ItzBuble/Bubleboard/3D Models/Keyboard_Armrest_Left.3mf

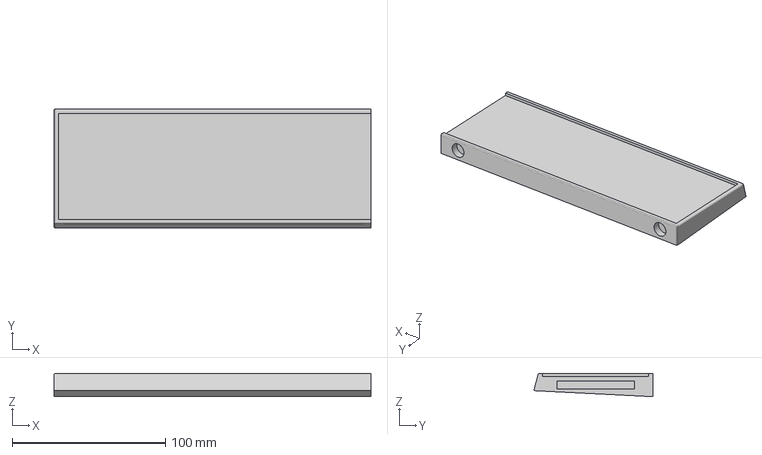
[picture p2: CAD file, 2026-10-11]
3D Models/Keyboard_Armrest_Left.3mf
207.0 x 78.0 x 15.3 mm
