ItzBuble/Bubleboard/3D Models/Keycaps/1.25x1.3mf

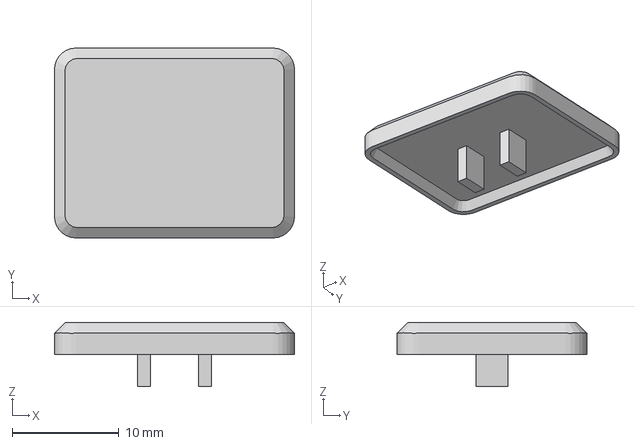
[picture p3: CAD file, 2026-10-11]
3D Models/Keycaps/1.25x1.3mf
22.5 x 17.8 x 6.02 mm
