ItzBuble/Bubleboard/3D Models/Keyboard_Case_Left.3mf

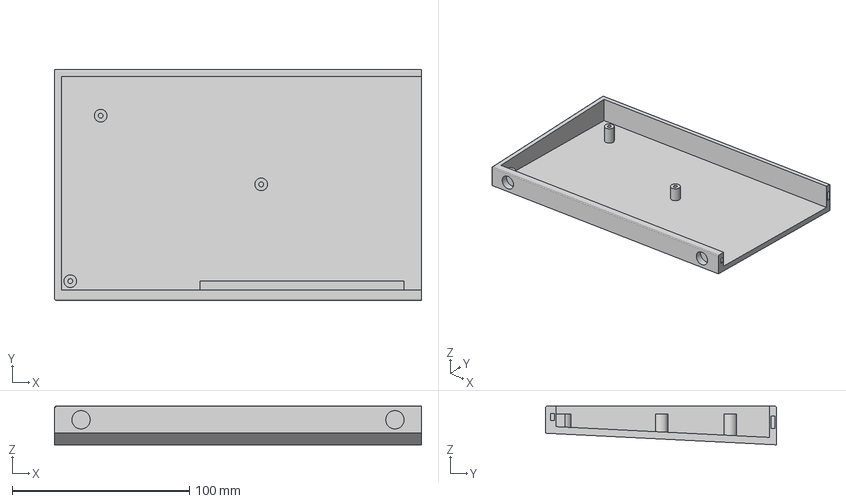
[picture p4: CAD file, 2026-10-11]
3D Models/Keyboard_Case_Left.3mf
207.0 x 130.3 x 21.8 mm
