ItzBuble/Bubleboard/3D Models/Keycaps/1x1.3mf

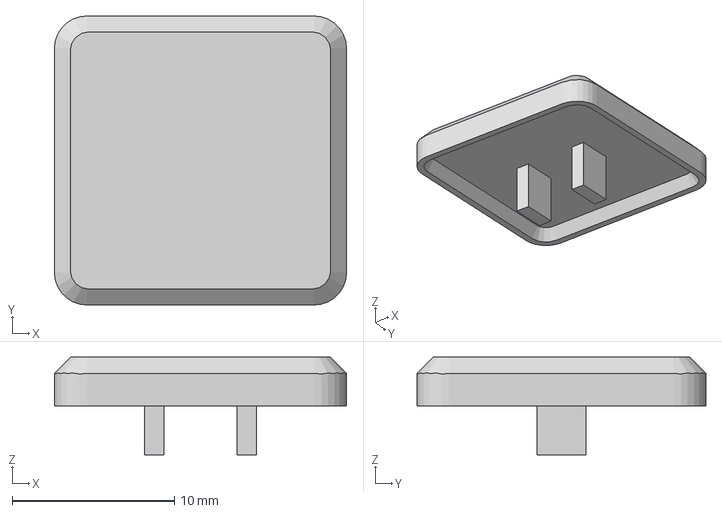
[picture p5: CAD file, 2026-10-11]
3D Models/Keycaps/1x1.3mf
18.0 x 17.8 x 6.02 mm
