ItzBuble/Bubleboard/3D Models/Keycaps/2.25x1.3mf

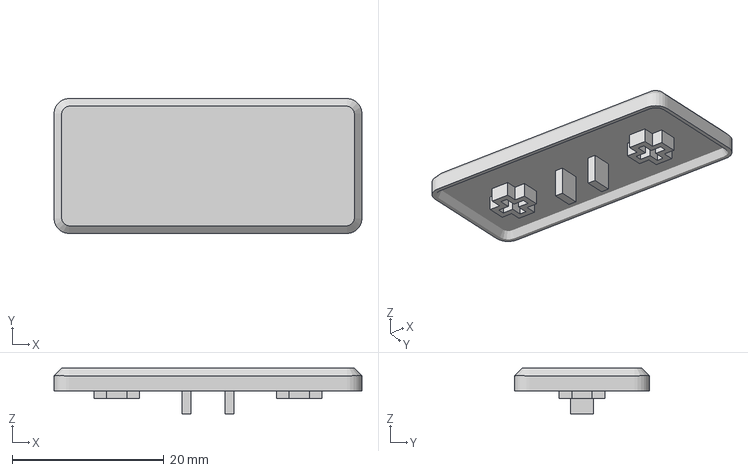
[picture p6: CAD file, 2026-10-11]
3D Models/Keycaps/2.25x1.3mf
40.6 x 17.8 x 6.02 mm
