ItzBuble/Bubleboard/3D Models/Keycaps/2.75x1.3mf

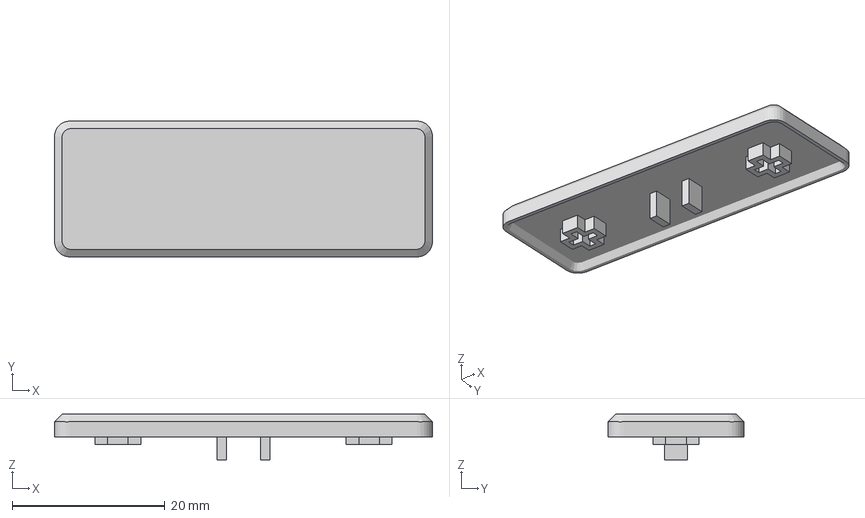
[picture p7: CAD file, 2026-10-11]
3D Models/Keycaps/2.75x1.3mf
49.5 x 17.8 x 6.02 mm
