ItzBuble/Bubleboard/3D Models/Keyboard_Display_Holder.3mf

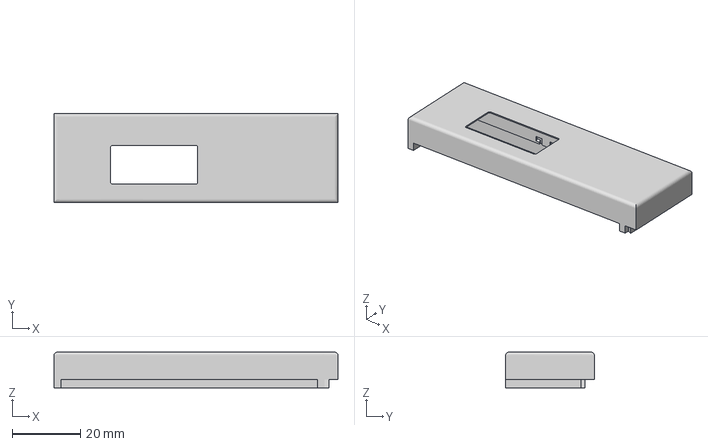
[picture p8: CAD file, 2026-10-11]
3D Models/Keyboard_Display_Holder.3mf
83.2 x 26.0 x 10.5 mm
