ItzBuble/Bubleboard/3D Models/Keycaps/2x1.3mf

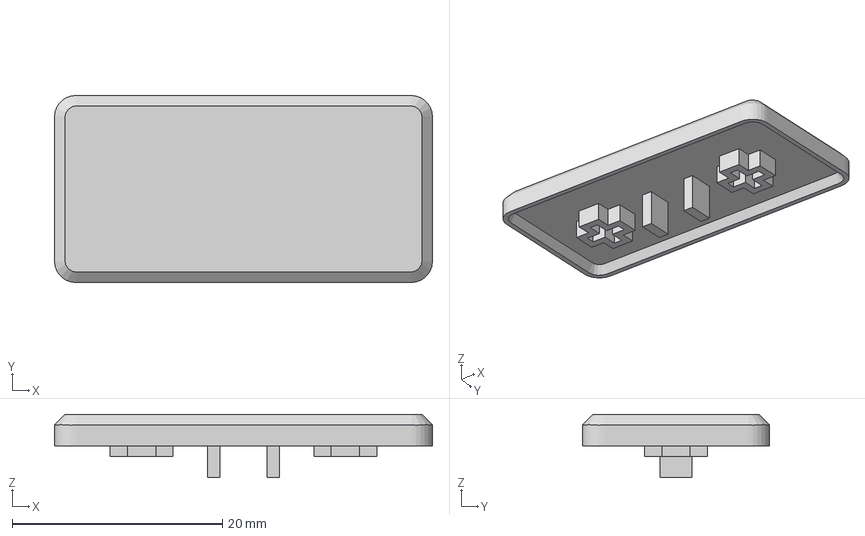
[picture p9: CAD file, 2026-10-11]
3D Models/Keycaps/2x1.3mf
36.0 x 17.8 x 6.02 mm
