ItzBuble/Bubleboard/3D Models/Keycaps/1.5x1.3mf

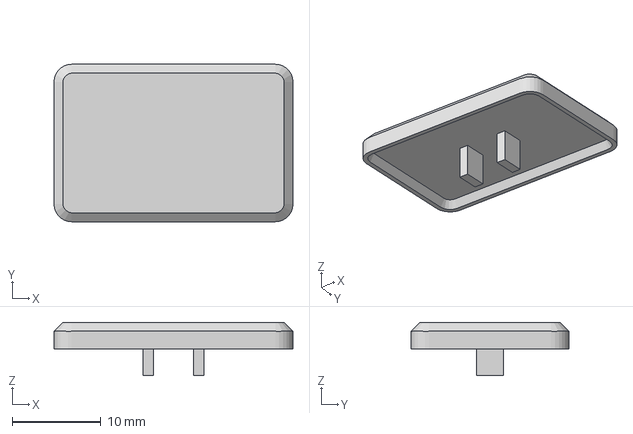
[picture p10: CAD file, 2026-10-11]
3D Models/Keycaps/1.5x1.3mf
27.0 x 17.8 x 6.02 mm
