ItzBuble/Bubleboard/3D Models/Keycaps/1.75x1.3mf

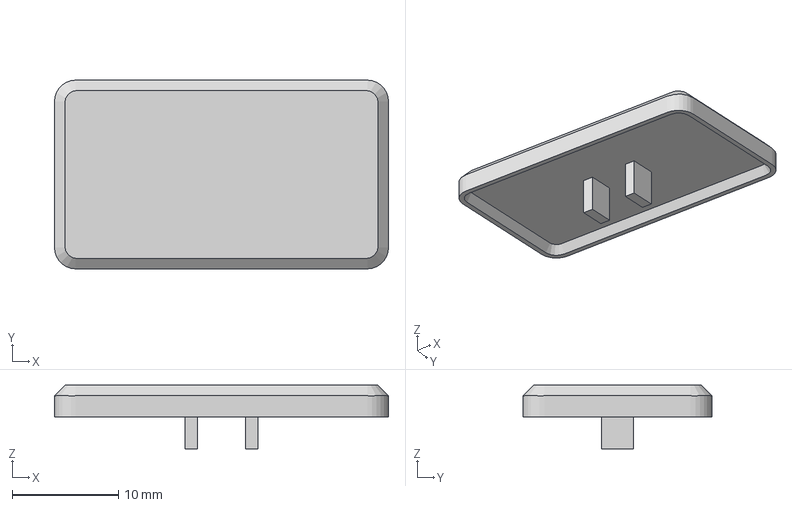
[picture p11: CAD file, 2026-10-11]
3D Models/Keycaps/1.75x1.3mf
31.5 x 17.8 x 6.02 mm
