ItzBuble/Bubleboard/3D Models/Keycaps/6.75x1.3mf

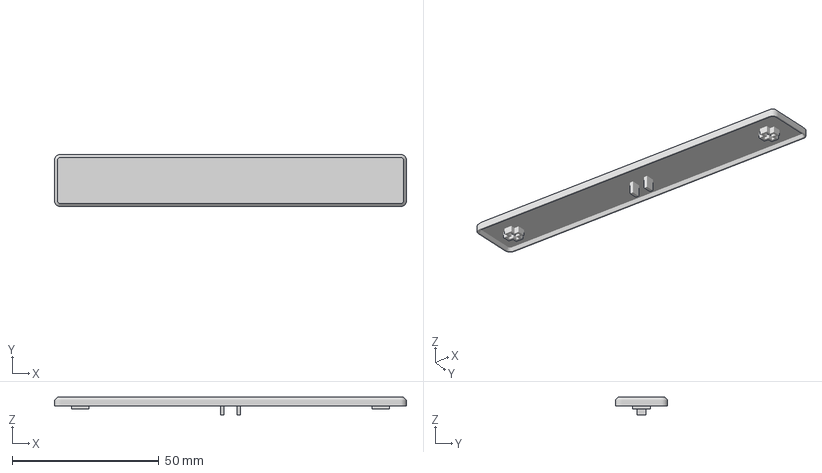
[picture p12: CAD file, 2026-10-11]
3D Models/Keycaps/6.75x1.3mf
120.0 x 17.8 x 6.02 mm
