ItzBuble/Bubleboard/3D Models/Keycaps/1x2.3mf

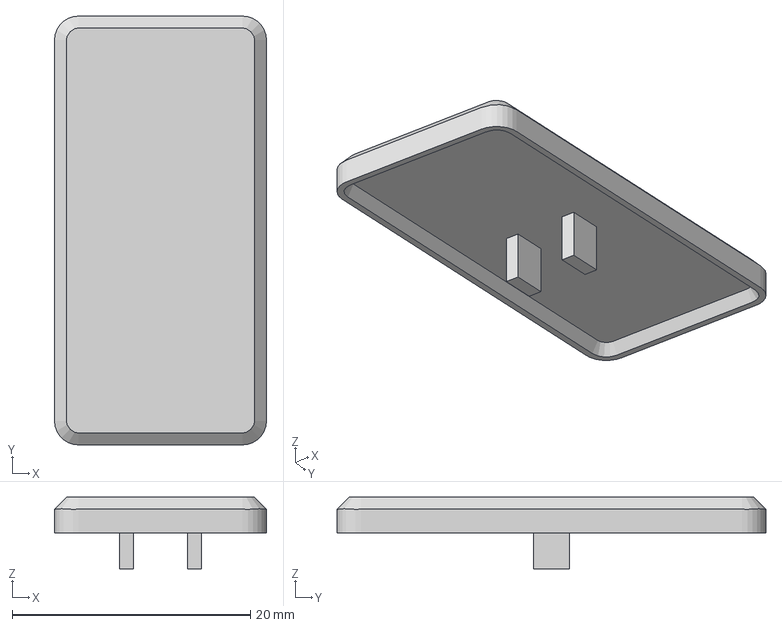
[picture p13: CAD file, 2026-10-11]
3D Models/Keycaps/1x2.3mf
17.8 x 36.0 x 6.02 mm
