ItzBuble/Bubleboard/(list of files, cad)

Other CAD files:
3D Models/Keyboard_Armrest_Right.3mf
3D Models/Keyboard_Case_Right.3mf
