ItzBuble/Bubleboard/Hardware/KeyboardSchematic.pdf

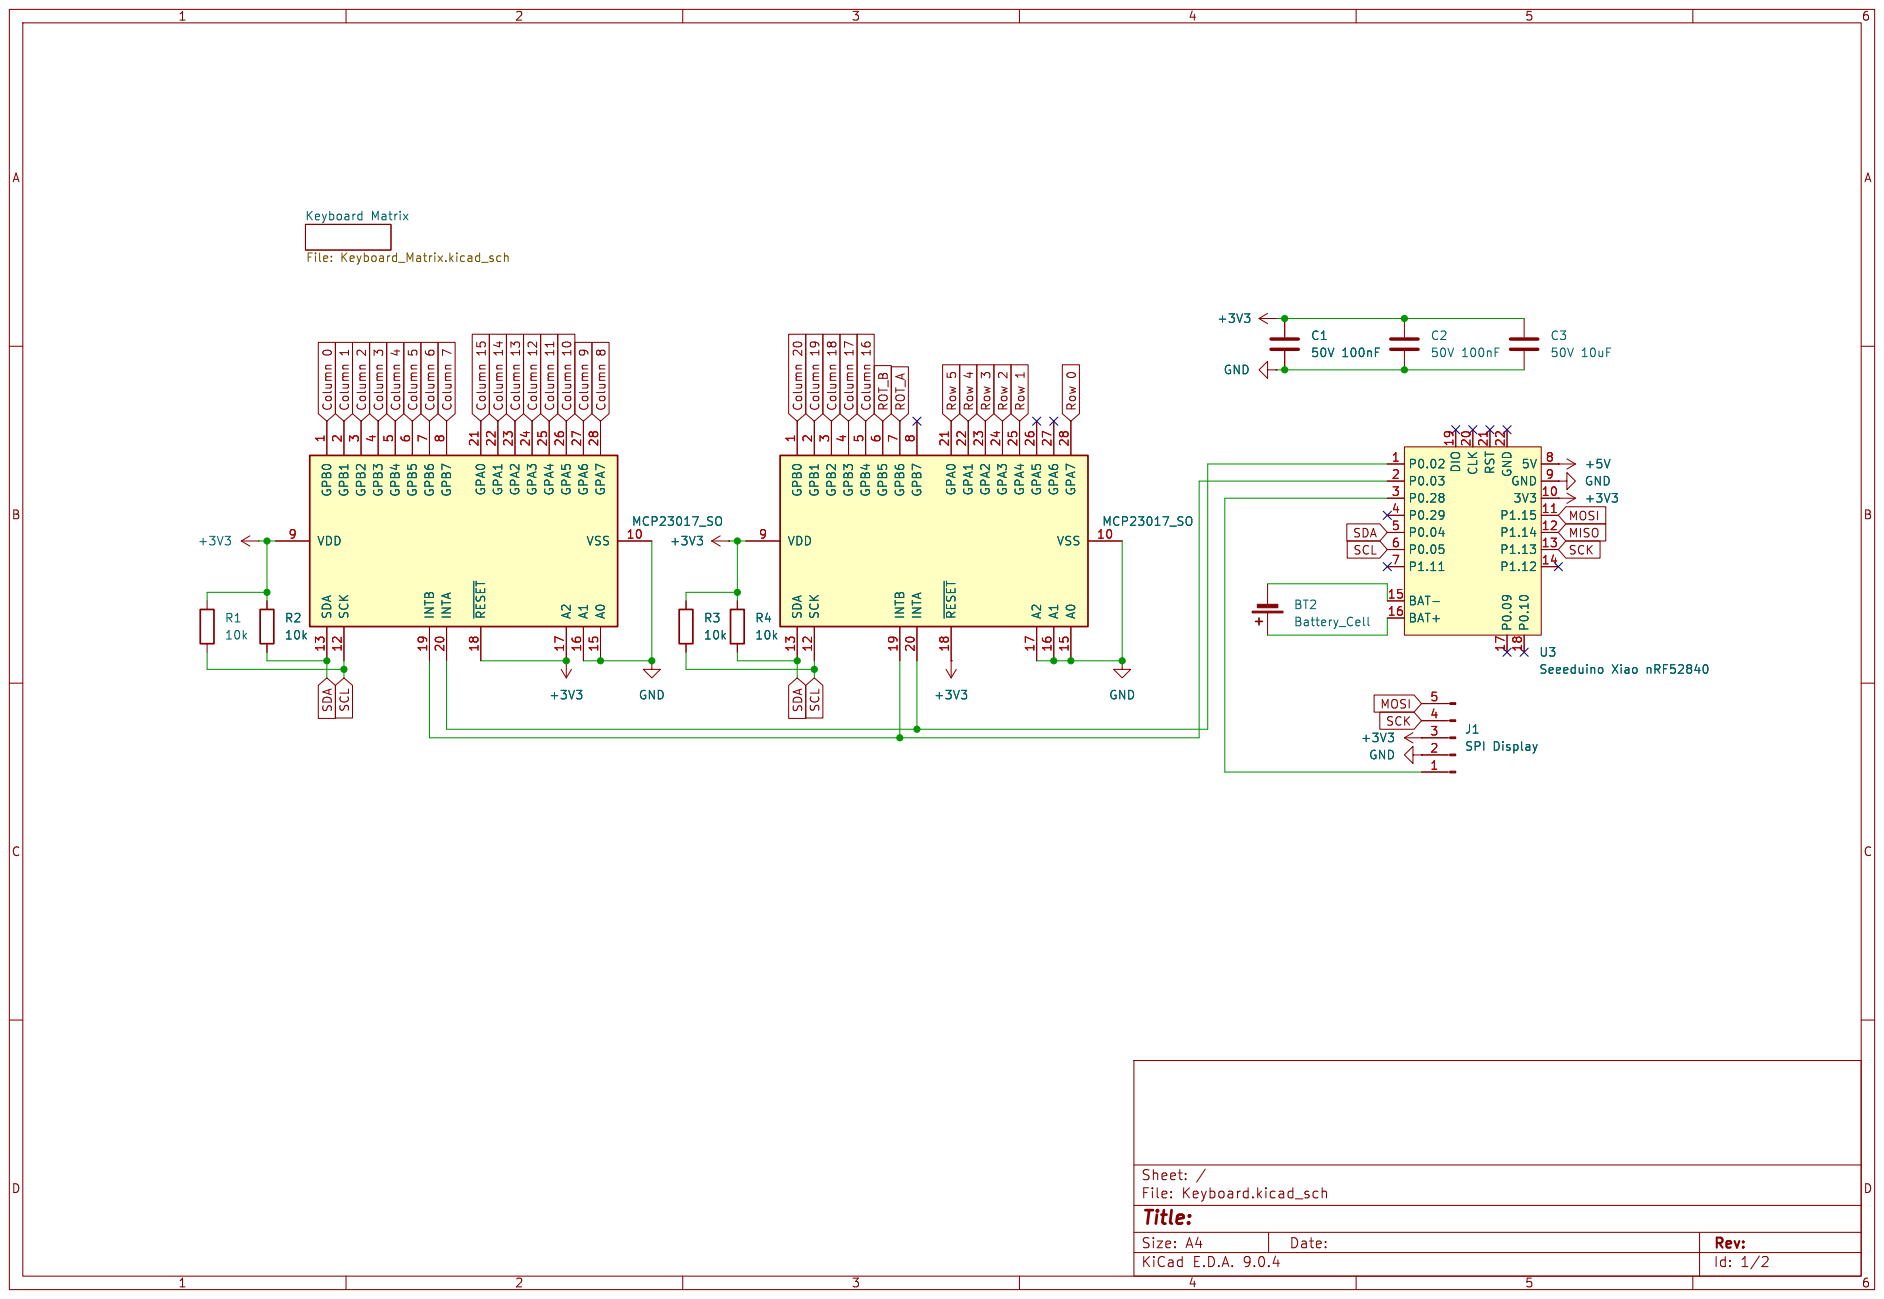
[picture p14: page 1]

8 GPA0 21 GPA1 22 GPA2 23 GPA3 24 GPA4 25 GPA5 26 GPA6 27 GPA7 28 MCP23017_SO SDA 13 SCK 12 INTB 19 INTA 20 ~{RESET} 18 A2 17 A1 16 A0 15 VDD 9 VSS 10 GPB0

Id: 1/2 Title: File: Keyboard.kicad_sch Sheet: /

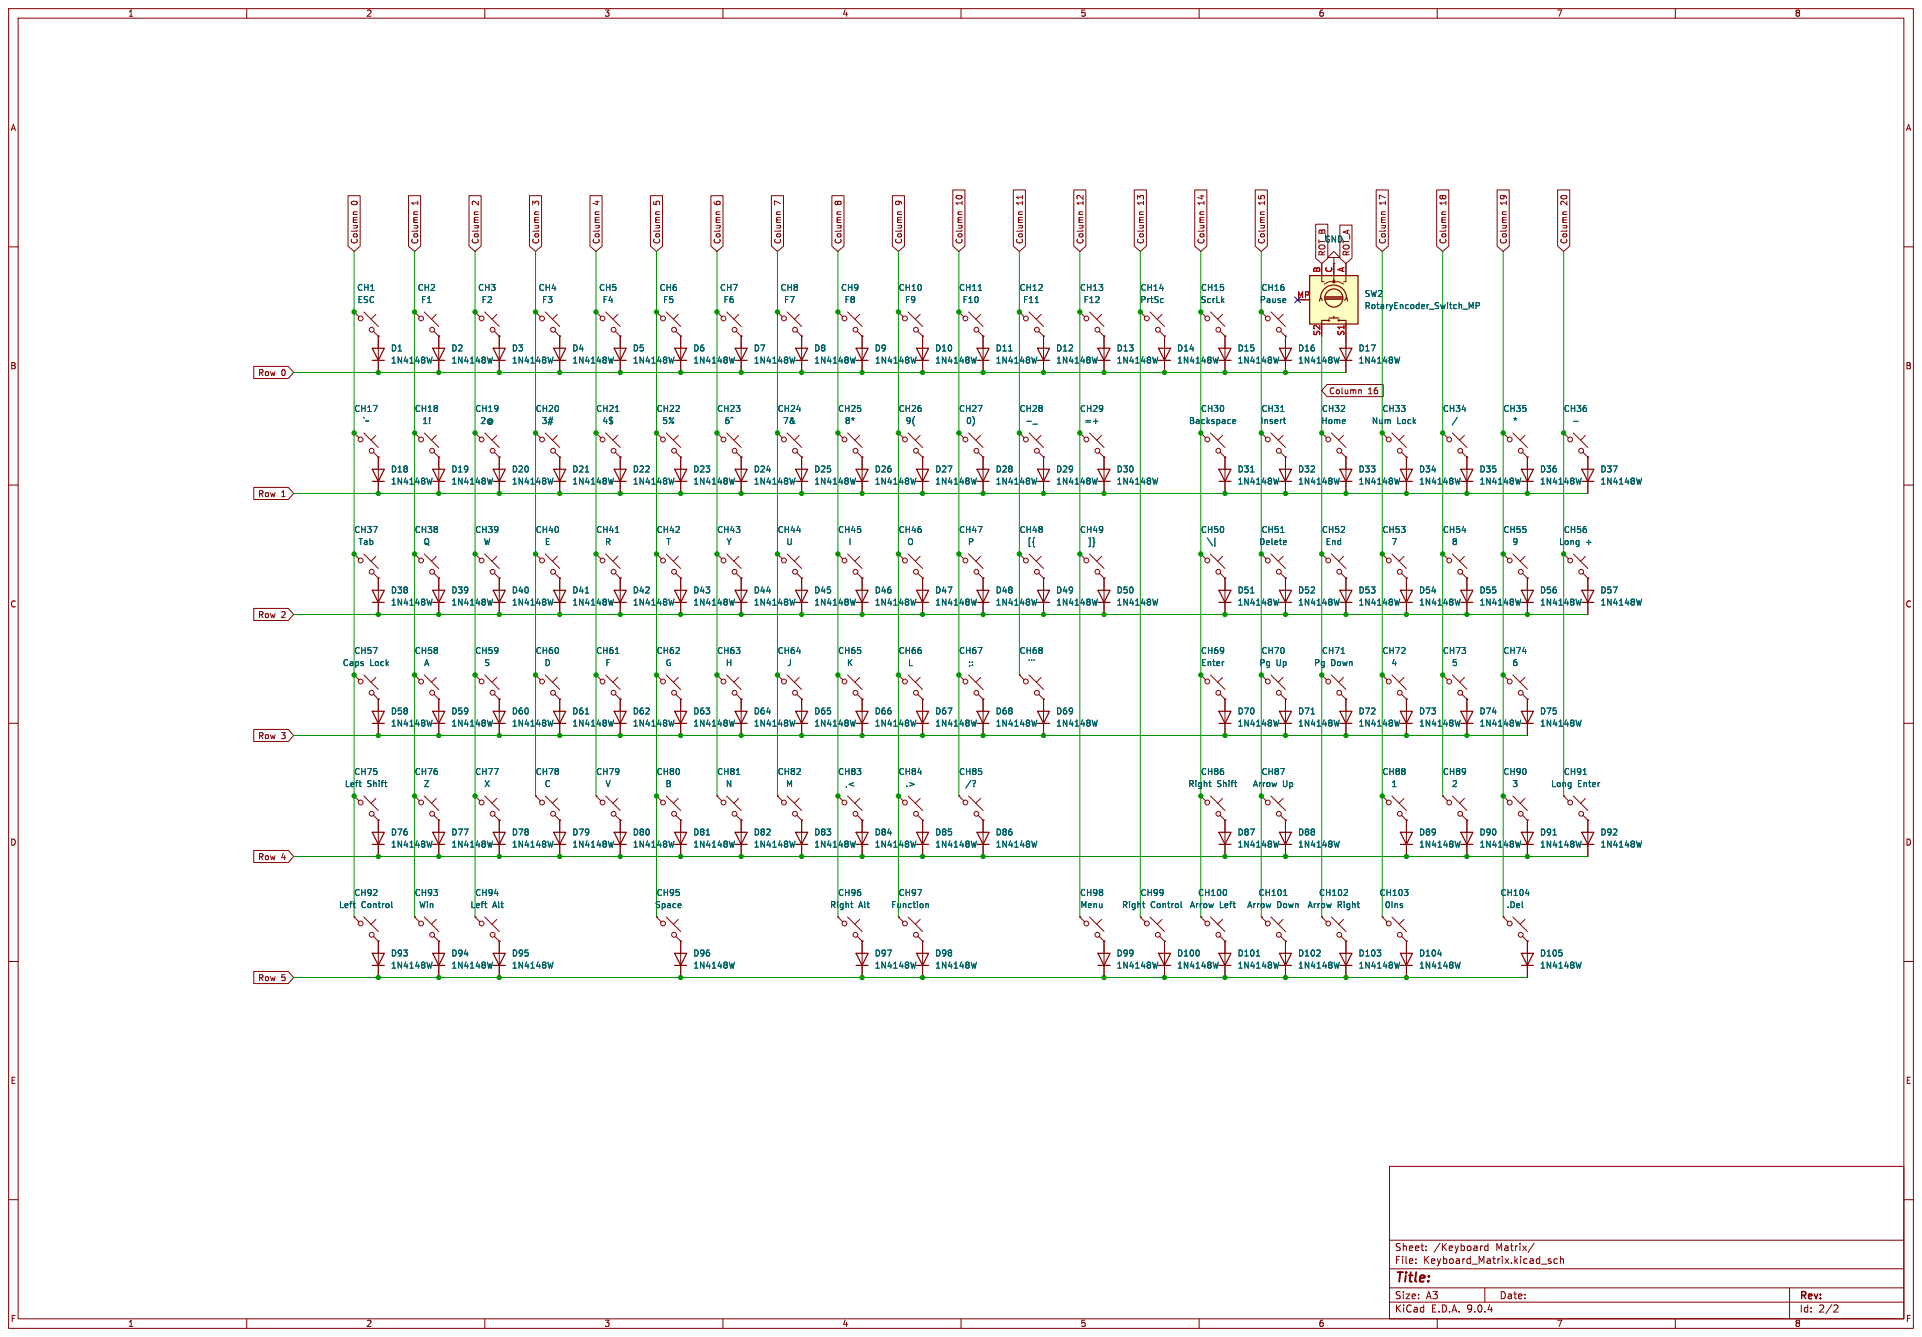
[picture p15: page 2]

CH87 Arrow Up CH86 Right Shift D44

CH87 Arrow Up CH86 Right Shift D87
