ItzBuble/Bubleboard/Hardware/Keyboard.kicad_pcb

## KiCad design Hardware/Keyboard.kicad_pcb (2025-10-13)

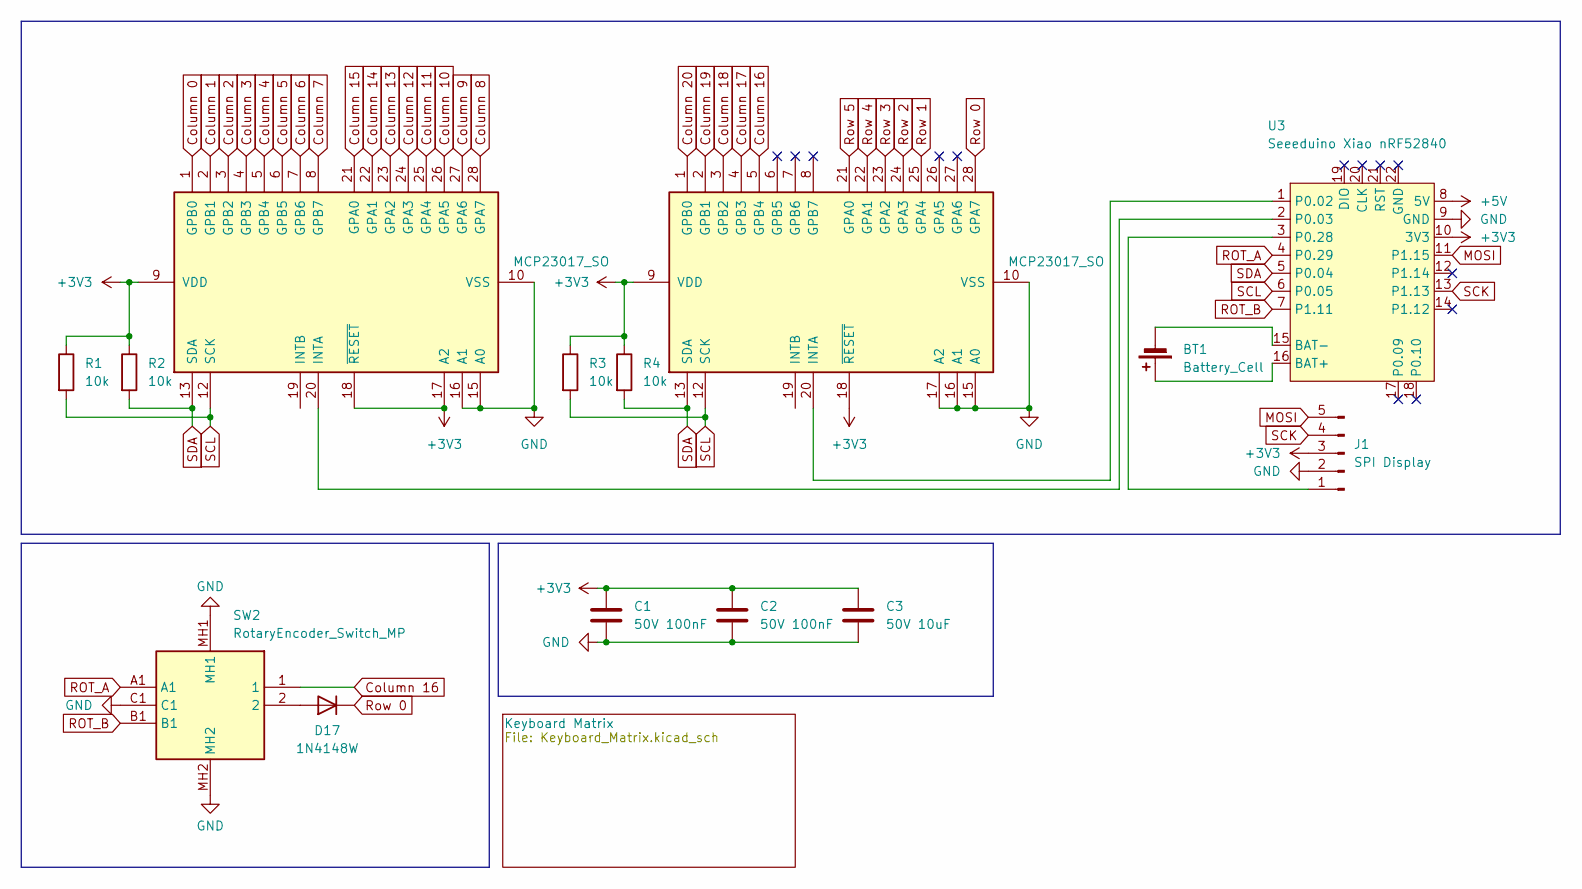
[picture p21: schematic Keyboard.kicad_sch]

Parts:
BT1: Battery_Cell
C1, C2: 50V 100nF; C_1206_3216Metric_Pad1.33x1.80mm_HandSolder
C3: 50V 10uF; C_1206_3216Metric_Pad1.33x1.80mm_HandSolder
D17: 1N4148W; D_SOD-123
J1: SPI Display
R1, R2, R3, R4: 10k; R_1206_3216Metric_Pad1.30x1.75mm_HandSolder
SW2: RotaryEncoder_Switch_MP; PEC11L4115FS0020; Mouser Part Number 652-PEC11L4115FS0020
U1, U2: MCP23017_SO; SOIC-28W_7.5x17.9mm_P1.27mm
U3: Seeeduino Xiao nRF52840; Xiao_nRF52840_ACH

Connections:
+3V3: C1.1, C2.1, C3.1, J1.3, R1.1, R2.1, R3.1, R4.1, U1.9 (VDD), U1.17 (A2), U1.18 (~RESET), U2.9 (VDD), U2.18 (~RESET), U3.10 (3V3)
+5V: U3.8 (5V)
Column 0: U1.1 (GPB0); also elsewhere on the board
Column 1: U1.2 (GPB1); also elsewhere on the board
Column 2: U1.3 (GPB2); also elsewhere on the board
Column 3: U1.4 (GPB3); also elsewhere on the board
Column 4: U1.5 (GPB4); also elsewhere on the board
Column 5: U1.6 (GPB5); also elsewhere on the board
Column 6: U1.7 (GPB6); also elsewhere on the board
Column 7: U1.8 (GPB7); also elsewhere on the board
Column 8: U1.28 (GPA7); also elsewhere on the board
Column 9: U1.27 (GPA6); also elsewhere on the board
Column 10: U1.26 (GPA5); also elsewhere on the board
Column 11: U1.25 (GPA4); also elsewhere on the board
Column 12: U1.24 (GPA3); also elsewhere on the board
Column 13: U1.23 (GPA2); also elsewhere on the board
Column 14: U1.22 (GPA1); also elsewhere on the board
Column 15: U1.21 (GPA0); also elsewhere on the board
Column 16: SW2.1, U2.5 (GPB4); also elsewhere on the board
Column 17: U2.4 (GPB3); also elsewhere on the board
Column 18: U2.3 (GPB2); also elsewhere on the board
Column 19: U2.2 (GPB1); also elsewhere on the board
Column 20: U2.1 (GPB0); also elsewhere on the board
GND: C1.2, C2.2, C3.2, J1.2, SW2.C1, SW2.MH1, SW2.MH2, U1.10 (VSS), U1.15 (A0), U1.16 (A1), U2.10 (VSS), U2.15 (A0), U2.16 (A1), U2.17 (A2), U3.9 (GND)
MOSI: J1.5, U3.11 (P1.15)
unnamed: D17.2 (A), SW2.2
unnamed: J1.1, U3.3 (P0.28)
unnamed: U1.20 (INTA), U3.2 (P0.03)
unnamed: U2.20 (INTA), U3.1 (P0.02)
unnamed: BT1.1 (+), U3.16 (BAT+)
unnamed: BT1.2 (-), U3.15 (BAT-)
ROT_A: SW2.A1, U3.4 (P0.29)
ROT_B: SW2.B1, U3.7 (P1.11)
Row 0: D17.1 (K), U2.28 (GPA7); also elsewhere on the board
Row 1: U2.25 (GPA4); also elsewhere on the board
Row 2: U2.24 (GPA3); also elsewhere on the board
Row 3: U2.23 (GPA2); also elsewhere on the board
Row 4: U2.22 (GPA1); also elsewhere on the board
Row 5: U2.21 (GPA0); also elsewhere on the board
SCK: J1.4, U3.13 (P1.13)
SCL: R1.2, R3.2, U1.12 (SCK), U2.12 (SCK), U3.6 (P0.05)
SDA: R2.2, R4.2, U1.13 (SDA), U2.13 (SDA), U3.5 (P0.04)

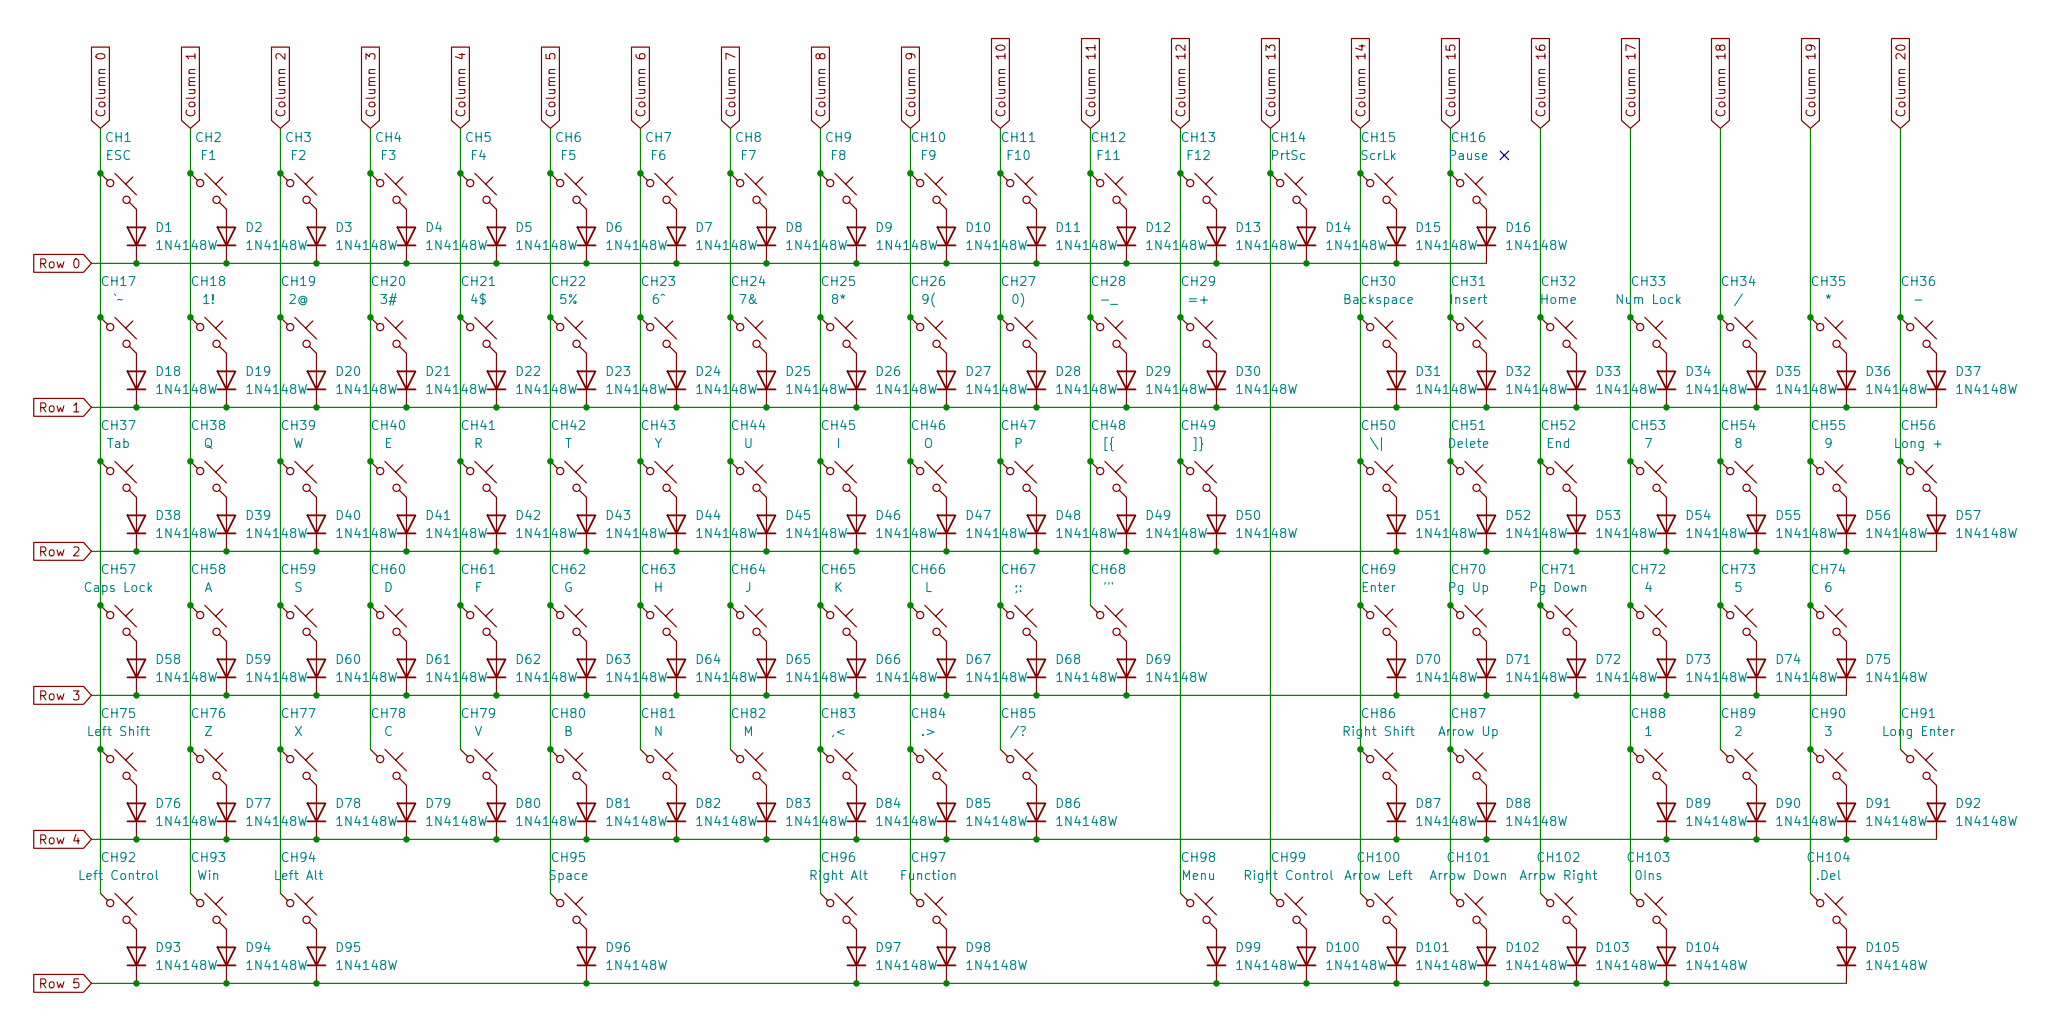
[picture p22: schematic Keyboard_Matrix.kicad_sch]

Parts:
CH1: ESC; SW_choc_v1_HS_CPG135001S30_1u
CH2: F1; SW_choc_v1_HS_CPG135001S30_1u
CH3: F2; SW_choc_v1_HS_CPG135001S30_1u
CH4: F3; SW_choc_v1_HS_CPG135001S30_1u
CH5: F4; SW_choc_v1_HS_CPG135001S30_1u
CH6: F5; SW_choc_v1_HS_CPG135001S30_1u
CH7: F6; SW_choc_v1_HS_CPG135001S30_1u
CH8: F7; SW_choc_v1_HS_CPG135001S30_1u
CH9: F8; SW_choc_v1_HS_CPG135001S30_1u
CH10: F9; SW_choc_v1_HS_CPG135001S30_1u
CH11: F10; SW_choc_v1_HS_CPG135001S30_1u
CH12: F11; SW_choc_v1_HS_CPG135001S30_1u
CH13: F12; SW_choc_v1_HS_CPG135001S30_1u
CH14: PrtSc; SW_choc_v1_HS_CPG135001S30_1u
CH15: ScrLk; SW_choc_v1_HS_CPG135001S30_1u
CH16: Pause; SW_choc_v1_HS_CPG135001S30_1u
CH17: `~; SW_choc_v1_HS_CPG135001S30_1u
CH18: 1!; SW_choc_v1_HS_CPG135001S30_1u
CH19: 2@; SW_choc_v1_HS_CPG135001S30_1u
CH20: 3#; SW_choc_v1_HS_CPG135001S30_1u
CH21: 4$; SW_choc_v1_HS_CPG135001S30_1u
CH22: 5%; SW_choc_v1_HS_CPG135001S30_1u
CH23: 6^; SW_choc_v1_HS_CPG135001S30_1u
CH24: 7&; SW_choc_v1_HS_CPG135001S30_1u
CH25: 8*; SW_choc_v1_HS_CPG135001S30_1u
CH26: 9(; SW_choc_v1_HS_CPG135001S30_1u
CH27: 0); SW_choc_v1_HS_CPG135001S30_1u
CH28: -_; SW_choc_v1_HS_CPG135001S30_1u
CH29: =+; SW_choc_v1_HS_CPG135001S30_1u
CH30: Backspace; SW_choc_v1_HS_CPG135001S30_1u
CH31: Insert; SW_choc_v1_HS_CPG135001S30_1u
CH32: Home; SW_choc_v1_HS_CPG135001S30_1u
CH33: Num Lock; SW_choc_v1_HS_CPG135001S30_1u
CH34: /; SW_choc_v1_HS_CPG135001S30_1u
CH35: *; SW_choc_v1_HS_CPG135001S30_1u
CH36: -; SW_choc_v1_HS_CPG135001S30_1u
CH37: Tab; SW_choc_v1_HS_CPG135001S30_1u
CH38: Q; SW_choc_v1_HS_CPG135001S30_1u
CH39: W; SW_choc_v1_HS_CPG135001S30_1u
CH40: E; SW_choc_v1_HS_CPG135001S30_1u
CH41: R; SW_choc_v1_HS_CPG135001S30_1u
CH42: T; SW_choc_v1_HS_CPG135001S30_1u
CH43: Y; SW_choc_v1_HS_CPG135001S30_1u
CH44: U; SW_choc_v1_HS_CPG135001S30_1u
CH45: I; SW_choc_v1_HS_CPG135001S30_1u
CH46: O; SW_choc_v1_HS_CPG135001S30_1u
CH47: P; SW_choc_v1_HS_CPG135001S30_1u
CH48: [{; SW_choc_v1_HS_CPG135001S30_1u
CH49: ]}; SW_choc_v1_HS_CPG135001S30_1u
CH50: \|; SW_choc_v1_HS_CPG135001S30_1u
CH51: Delete; SW_choc_v1_HS_CPG135001S30_1u
CH52: End; SW_choc_v1_HS_CPG135001S30_1u
CH53: 7; SW_choc_v1_HS_CPG135001S30_1u
CH54: 8; SW_choc_v1_HS_CPG135001S30_1u
CH55: 9; SW_choc_v1_HS_CPG135001S30_1u
CH56: Long +; SW_choc_v1_HS_CPG135001S30_1u
CH57: Caps Lock; SW_choc_v1_HS_CPG135001S30_1u
CH58: A; SW_choc_v1_HS_CPG135001S30_1u
CH59: S; SW_choc_v1_HS_CPG135001S30_1u
CH60: D; SW_choc_v1_HS_CPG135001S30_1u
CH61: F; SW_choc_v1_HS_CPG135001S30_1u
CH62: G; SW_choc_v1_HS_CPG135001S30_1u
CH63: H; SW_choc_v1_HS_CPG135001S30_1u
CH64: J; SW_choc_v1_HS_CPG135001S30_1u
CH65: K; SW_choc_v1_HS_CPG135001S30_1u
CH66: L; SW_choc_v1_HS_CPG135001S30_1u
CH67: ;:; SW_choc_v1_HS_CPG135001S30_1u
CH68: '"; SW_choc_v1_HS_CPG135001S30_1u
CH69: Enter; SW_choc_v1_HS_CPG135001S30_1u
CH70: Pg Up; SW_choc_v1_HS_CPG135001S30_1u
CH71: Pg Down; SW_choc_v1_HS_CPG135001S30_1u
CH72: 4; SW_choc_v1_HS_CPG135001S30_1u
CH73: 5; SW_choc_v1_HS_CPG135001S30_1u
CH74: 6; SW_choc_v1_HS_CPG135001S30_1u
CH75: Left Shift; SW_choc_v1_HS_CPG135001S30_1u
CH76: Z; SW_choc_v1_HS_CPG135001S30_1u
CH77: X; SW_choc_v1_HS_CPG135001S30_1u
CH78: C; SW_choc_v1_HS_CPG135001S30_1u
CH79: V; SW_choc_v1_HS_CPG135001S30_1u
CH80: B; SW_choc_v1_HS_CPG135001S30_1u
CH81: N; SW_choc_v1_HS_CPG135001S30_1u
CH82: M; SW_choc_v1_HS_CPG135001S30_1u
CH83: ,<; SW_choc_v1_HS_CPG135001S30_1u
CH84: .>; SW_choc_v1_HS_CPG135001S30_1u
CH85: /?; SW_choc_v1_HS_CPG135001S30_1u
CH86: Right Shift; SW_choc_v1_HS_CPG135001S30_1u
CH87: Arrow Up; SW_choc_v1_HS_CPG135001S30_1u
CH88: 1; SW_choc_v1_HS_CPG135001S30_1u
CH89: 2; SW_choc_v1_HS_CPG135001S30_1u
CH90: 3; SW_choc_v1_HS_CPG135001S30_1u
CH91: Long Enter; SW_choc_v1_HS_CPG135001S30_1u
CH92: Left Control; SW_choc_v1_HS_CPG135001S30_1u
CH93: Win; SW_choc_v1_HS_CPG135001S30_1u
CH94: Left Alt; SW_choc_v1_HS_CPG135001S30_1u
CH95: Space; SW_choc_v1_HS_CPG135001S30_1u
CH96: Right Alt; SW_choc_v1_HS_CPG135001S30_1u
CH97: Function; SW_choc_v1_HS_CPG135001S30_1u
CH98: Menu; SW_choc_v1_HS_CPG135001S30_1u
CH99: Right Control; SW_choc_v1_HS_CPG135001S30_1u
CH100: Arrow Left; SW_choc_v1_HS_CPG135001S30_1u
CH101: Arrow Down; SW_choc_v1_HS_CPG135001S30_1u
CH102: Arrow Right; SW_choc_v1_HS_CPG135001S30_1u
CH103: 0Ins; SW_choc_v1_HS_CPG135001S30_1u
CH104: .Del; SW_choc_v1_HS_CPG135001S30_1u
D1, D2, D3, D4, D5, D6, D7, D8, D9, D10, D11, D12, D13, D14, D15, D16, D18, D19, D20, D21, D22, D23, D24, D25, D26, D27, D28, D29, D30, D31, D32, D33, D34, D35, D36, D37, D38, D39, D40, D41, D42, D43, D44, D45, D46, D47, D48, D49, D50, D51, D52, D53, D54, D55, D56, D57, D58, D59, D60, D61, D62, D63, D64, D65, D66, D67, D68, D69, D70, D71, D72, D73, D74, D75, D76, D77, D78, D79, D80, D81, D82, D83, D84, D85, D86, D87, D88, D89, D90, D91, D92, D93, D94, D95, D96, D97, D98, D99, D100, D101, D102, D103, D104, D105: 1N4148W; D_SOD-123

Connections:
Column 0: CH1.1, CH17.1, CH37.1, CH57.1, CH75.1, CH92.1; also elsewhere on the board
Column 1: CH2.1, CH18.1, CH38.1, CH58.1, CH76.1, CH93.1; also elsewhere on the board
Column 2: CH3.1, CH19.1, CH39.1, CH59.1, CH77.1, CH94.1; also elsewhere on the board
Column 3: CH4.1, CH20.1, CH40.1, CH60.1, CH78.1; also elsewhere on the board
Column 4: CH5.1, CH21.1, CH41.1, CH61.1, CH79.1; also elsewhere on the board
Column 5: CH6.1, CH22.1, CH42.1, CH62.1, CH80.1, CH95.1; also elsewhere on the board
Column 6: CH7.1, CH23.1, CH43.1, CH63.1, CH81.1; also elsewhere on the board
Column 7: CH8.1, CH24.1, CH44.1, CH64.1, CH82.1; also elsewhere on the board
Column 8: CH9.1, CH25.1, CH45.1, CH65.1, CH83.1, CH96.1; also elsewhere on the board
Column 9: CH10.1, CH26.1, CH46.1, CH66.1, CH84.1, CH97.1; also elsewhere on the board
Column 10: CH11.1, CH27.1, CH47.1, CH67.1, CH85.1; also elsewhere on the board
Column 11: CH12.1, CH28.1, CH48.1, CH68.1; also elsewhere on the board
Column 12: CH13.1, CH29.1, CH49.1, CH98.1; also elsewhere on the board
Column 13: CH14.1, CH99.1; also elsewhere on the board
Column 14: CH15.1, CH30.1, CH50.1, CH69.1, CH86.1, CH100.1; also elsewhere on the board
Column 15: CH16.1, CH31.1, CH51.1, CH70.1, CH87.1, CH101.1; also elsewhere on the board
Column 16: CH32.1, CH52.1, CH71.1, CH102.1; also elsewhere on the board
Column 17: CH33.1, CH53.1, CH72.1, CH88.1, CH103.1; also elsewhere on the board
Column 18: CH34.1, CH54.1, CH73.1, CH89.1; also elsewhere on the board
Column 19: CH35.1, CH55.1, CH74.1, CH90.1, CH104.1; also elsewhere on the board
Column 20: CH36.1, CH56.1, CH91.1; also elsewhere on the board
unnamed: CH1.2, D1.2 (A)
unnamed: CH2.2, D2.2 (A)
unnamed: CH3.2, D3.2 (A)
unnamed: CH4.2, D4.2 (A)
unnamed: CH5.2, D5.2 (A)
unnamed: CH6.2, D6.2 (A)
unnamed: CH7.2, D7.2 (A)
unnamed: CH8.2, D8.2 (A)
unnamed: CH9.2, D9.2 (A)
unnamed: CH10.2, D10.2 (A)
unnamed: CH11.2, D11.2 (A)
unnamed: CH12.2, D12.2 (A)
unnamed: CH13.2, D13.2 (A)
unnamed: CH14.2, D14.2 (A)
unnamed: CH15.2, D15.2 (A)
unnamed: CH16.2, D16.2 (A)
unnamed: CH17.2, D18.2 (A)
unnamed: CH18.2, D19.2 (A)
unnamed: CH19.2, D20.2 (A)
unnamed: CH20.2, D21.2 (A)
unnamed: CH21.2, D22.2 (A)
unnamed: CH22.2, D23.2 (A)
unnamed: CH23.2, D24.2 (A)
unnamed: CH24.2, D25.2 (A)
unnamed: CH25.2, D26.2 (A)
unnamed: CH26.2, D27.2 (A)
unnamed: CH27.2, D28.2 (A)
unnamed: CH28.2, D29.2 (A)
unnamed: CH29.2, D30.2 (A)
unnamed: CH30.2, D31.2 (A)
unnamed: CH31.2, D32.2 (A)
unnamed: CH32.2, D33.2 (A)
unnamed: CH33.2, D34.2 (A)
unnamed: CH34.2, D35.2 (A)
unnamed: CH35.2, D36.2 (A)
unnamed: CH36.2, D37.2 (A)
unnamed: CH37.2, D38.2 (A)
unnamed: CH38.2, D39.2 (A)
unnamed: CH39.2, D40.2 (A)
unnamed: CH40.2, D41.2 (A)
unnamed: CH41.2, D42.2 (A)
unnamed: CH42.2, D43.2 (A)
unnamed: CH43.2, D44.2 (A)
unnamed: CH44.2, D45.2 (A)
unnamed: CH45.2, D46.2 (A)
unnamed: CH46.2, D47.2 (A)
unnamed: CH47.2, D48.2 (A)
unnamed: CH48.2, D49.2 (A)
unnamed: CH49.2, D50.2 (A)
unnamed: CH50.2, D51.2 (A)
unnamed: CH51.2, D52.2 (A)
unnamed: CH52.2, D53.2 (A)
unnamed: CH53.2, D54.2 (A)
unnamed: CH54.2, D55.2 (A)
unnamed: CH55.2, D56.2 (A)
unnamed: CH56.2, D57.2 (A)
unnamed: CH57.2, D58.2 (A)
unnamed: CH58.2, D59.2 (A)
unnamed: CH59.2, D60.2 (A)
unnamed: CH60.2, D61.2 (A)
unnamed: CH61.2, D62.2 (A)
unnamed: CH62.2, D63.2 (A)
unnamed: CH63.2, D64.2 (A)
unnamed: CH64.2, D65.2 (A)
unnamed: CH65.2, D66.2 (A)
unnamed: CH66.2, D67.2 (A)
unnamed: CH67.2, D68.2 (A)
unnamed: CH68.2, D69.2 (A)
unnamed: CH69.2, D70.2 (A)
unnamed: CH70.2, D71.2 (A)
unnamed: CH71.2, D72.2 (A)
unnamed: CH72.2, D73.2 (A)
unnamed: CH73.2, D74.2 (A)
unnamed: CH74.2, D75.2 (A)
unnamed: CH75.2, D76.2 (A)
unnamed: CH76.2, D77.2 (A)
unnamed: CH77.2, D78.2 (A)
unnamed: CH78.2, D79.2 (A)
unnamed: CH79.2, D80.2 (A)
unnamed: CH80.2, D81.2 (A)
unnamed: CH81.2, D82.2 (A)
unnamed: CH82.2, D83.2 (A)
unnamed: CH83.2, D84.2 (A)
unnamed: CH84.2, D85.2 (A)
unnamed: CH85.2, D86.2 (A)
unnamed: CH86.2, D87.2 (A)
unnamed: CH87.2, D88.2 (A)
unnamed: CH88.2, D89.2 (A)
unnamed: CH89.2, D90.2 (A)
unnamed: CH90.2, D91.2 (A)
unnamed: CH91.2, D92.2 (A)
unnamed: CH92.2, D93.2 (A)
unnamed: CH93.2, D94.2 (A)
unnamed: CH94.2, D95.2 (A)
unnamed: CH95.2, D96.2 (A)
unnamed: CH96.2, D97.2 (A)
unnamed: CH97.2, D98.2 (A)
unnamed: CH98.2, D99.2 (A)
unnamed: CH99.2, D100.2 (A)
unnamed: CH100.2, D101.2 (A)
unnamed: CH101.2, D102.2 (A)
unnamed: CH102.2, D103.2 (A)
unnamed: CH103.2, D104.2 (A)
unnamed: CH104.2, D105.2 (A)
Row 0: D1.1 (K), D2.1 (K), D3.1 (K), D4.1 (K), D5.1 (K), D6.1 (K), D7.1 (K), D8.1 (K), D9.1 (K), D10.1 (K), D11.1 (K), D12.1 (K), D13.1 (K), D14.1 (K), D15.1 (K), D16.1 (K); also elsewhere on the board
Row 1: D18.1 (K), D19.1 (K), D20.1 (K), D21.1 (K), D22.1 (K), D23.1 (K), D24.1 (K), D25.1 (K), D26.1 (K), D27.1 (K), D28.1 (K), D29.1 (K), D30.1 (K), D31.1 (K), D32.1 (K), D33.1 (K), D34.1 (K), D35.1 (K), D36.1 (K), D37.1 (K); also elsewhere on the board
Row 2: D38.1 (K), D39.1 (K), D40.1 (K), D41.1 (K), D42.1 (K), D43.1 (K), D44.1 (K), D45.1 (K), D46.1 (K), D47.1 (K), D48.1 (K), D49.1 (K), D50.1 (K), D51.1 (K), D52.1 (K), D53.1 (K), D54.1 (K), D55.1 (K), D56.1 (K), D57.1 (K); also elsewhere on the board
Row 3: D58.1 (K), D59.1 (K), D60.1 (K), D61.1 (K), D62.1 (K), D63.1 (K), D64.1 (K), D65.1 (K), D66.1 (K), D67.1 (K), D68.1 (K), D69.1 (K), D70.1 (K), D71.1 (K), D72.1 (K), D73.1 (K), D74.1 (K), D75.1 (K); also elsewhere on the board
Row 4: D76.1 (K), D77.1 (K), D78.1 (K), D79.1 (K), D80.1 (K), D81.1 (K), D82.1 (K), D83.1 (K), D84.1 (K), D85.1 (K), D86.1 (K), D87.1 (K), D88.1 (K), D89.1 (K), D90.1 (K), D91.1 (K), D92.1 (K); also elsewhere on the board
Row 5: D93.1 (K), D94.1 (K), D95.1 (K), D96.1 (K), D97.1 (K), D98.1 (K), D99.1 (K), D100.1 (K), D101.1 (K), D102.1 (K), D103.1 (K), D104.1 (K), D105.1 (K); also elsewhere on the board

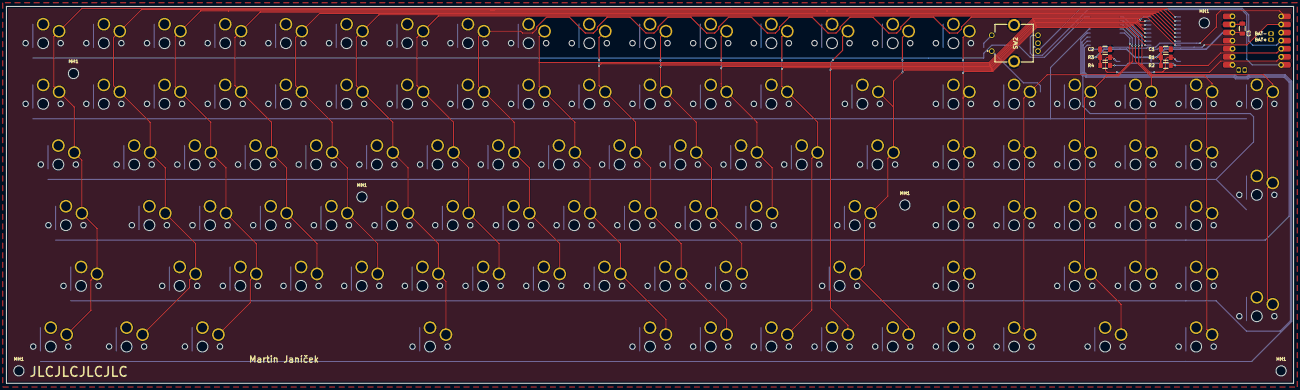
[picture p23: board Keyboard.kicad_pcb from above]

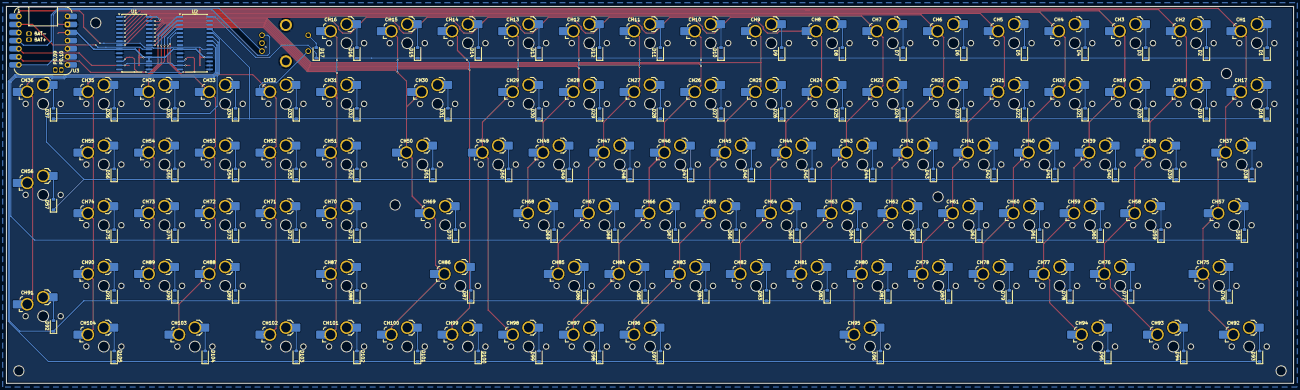
[picture p24: board Keyboard.kicad_pcb from below]

Board: 2 copper layers, 404.0 x 118.3 mm, 226 parts (212 on the bottom side), 140 nets.

Other parts of the board:
MH1, MH1#2, MH1#3, MH1#4, MH1#5, MH1#6: MountingHole_3.2mm_M3_ISO14580
