ItzBuble/Bubleboard/(commit log)

2025-09-09 Removed useless files from the repo
    [LEDs.kicad_sch]
2025-09-09 Added the OLED SPI Display and remade the entire PCB
    [Keyboard.kicad_pcb, Keyboard.kicad_sch, Keyboard_Matrix.kicad_sch]
2025-09-09 Fixed warnings about silkscreen clipping with the solder mask
    [Keyboard.kicad_pcb]
2025-09-09 Added PDF exports of the schematic and the PCB to allow easy viewing without using kicad
2025-09-10 Added Mounting Holes to the PCB
    [Keyboard.kicad_pcb]
2025-09-10 Flipped the Seeed Xiao
    [Keyboard.kicad_pcb]
2025-09-18 Minor update.
    [Keyboard.kicad_pcb]
2025-09-18 Added the Display holder 3D model for the case.
    [Display Slide In.stl]
2025-09-18 Fixed battery symbol errors.
    [Keyboard.kicad_sch]
2025-09-18 Made little design changes to the schematic.
    [Keyboard.kicad_sch]
2025-09-18 Added text to the pcb.
    [Keyboard.kicad_pcb]
2025-09-18 Updated footprints.
    [Keyboard.kicad_pcb]
2025-09-18 Replaced Rotary Encoder.
    [Keyboard.kicad_pcb, Keyboard.kicad_sch, Keyboard_Matrix.kicad_sch]
2025-10-02 Changed routing.
    [Keyboard.kicad_pcb, Keyboard.kicad_sch]
2025-10-13 Fixed issues with JLCDFM.
    [Keyboard.kicad_pcb]
2026-10-11 Reorganize files.
    [Display Slide In.stl, Keyboard.kicad_pcb, Keyboard.kicad_sch, Keyboard_Matrix.kicad_sch]
2026-10-11 Updated 3D models.
    [1.25x1.3mf, 1.5x1.3mf, 1.75x1.3mf, 1x1.3mf, 1x2.3mf, 2.25x1.3mf, 2.75x1.3mf, 2x1.3mf]
